DudeYarvie/JARViE_Bus_Extender/Reference Docs/Pics/Board_Annotated.jpg

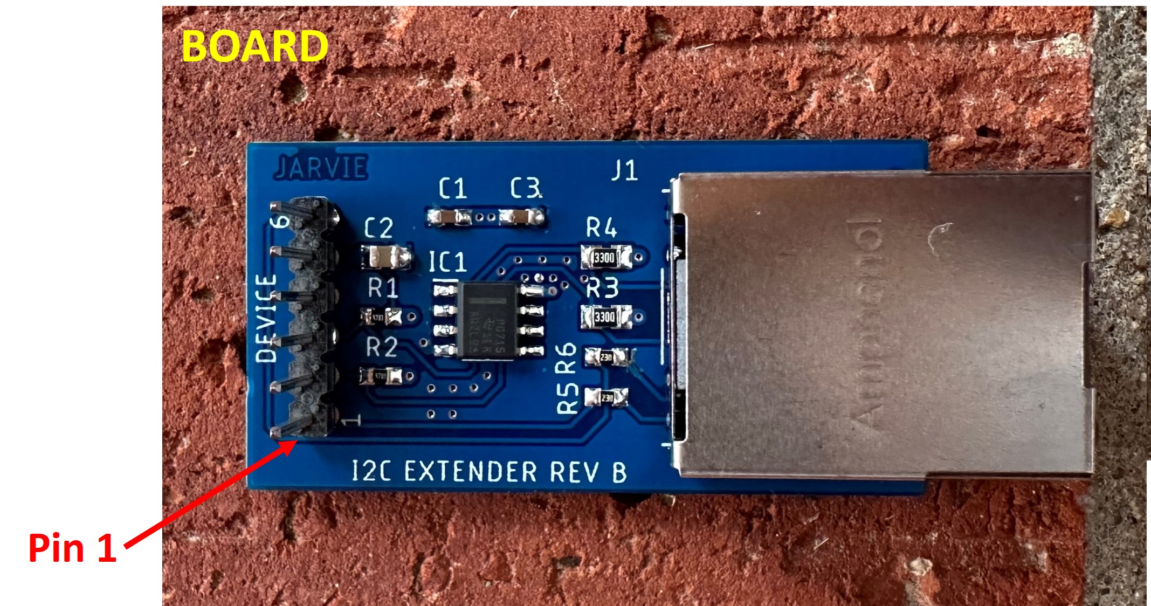
Reference Docs/Pics/Board_Annotated.jpg
