DudeYarvie/JARViE_Bus_Extender/Reference Docs/Pics/Buffer_Block_Diagram.jpg

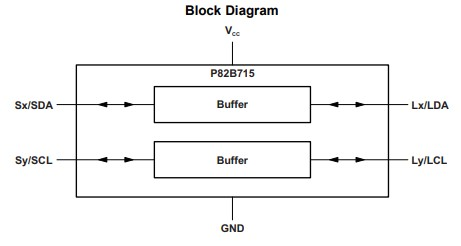
Reference Docs/Pics/Buffer_Block_Diagram.jpg
