DudeYarvie/JARViE_Bus_Extender/Reference Docs/Pics/Waveform_Measurements_Annotated.jpg

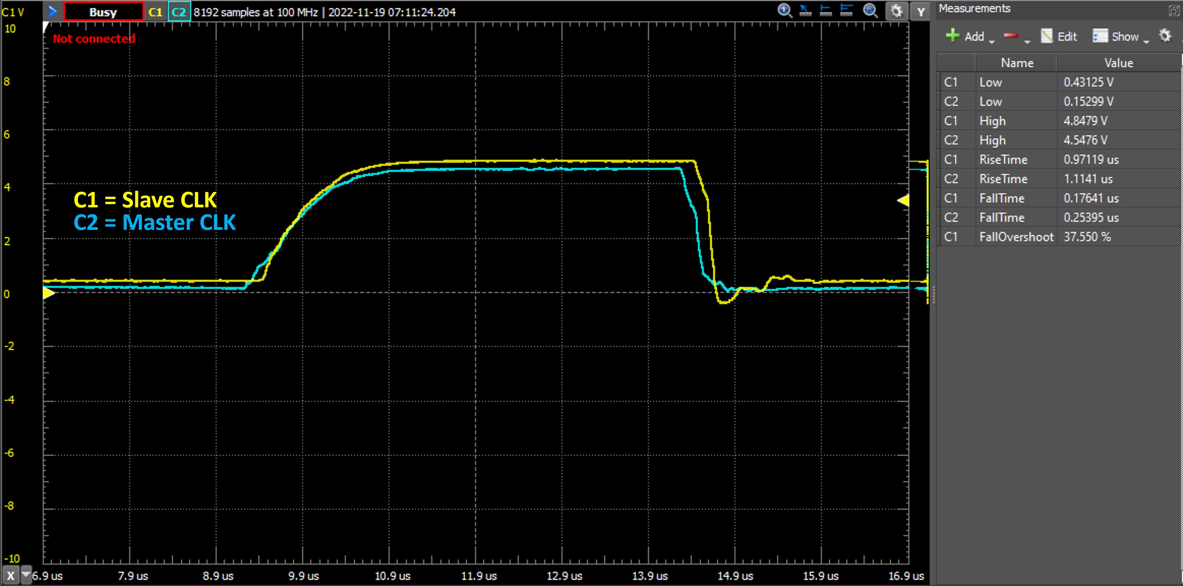
Reference Docs/Pics/Waveform_Measurements_Annotated.jpg
