DudeYarvie/JARViE_Bus_Extender/Reference Docs/I2C_SPI_extender/SCH, I2C_SPI_EXTENDER.pdf

A

A

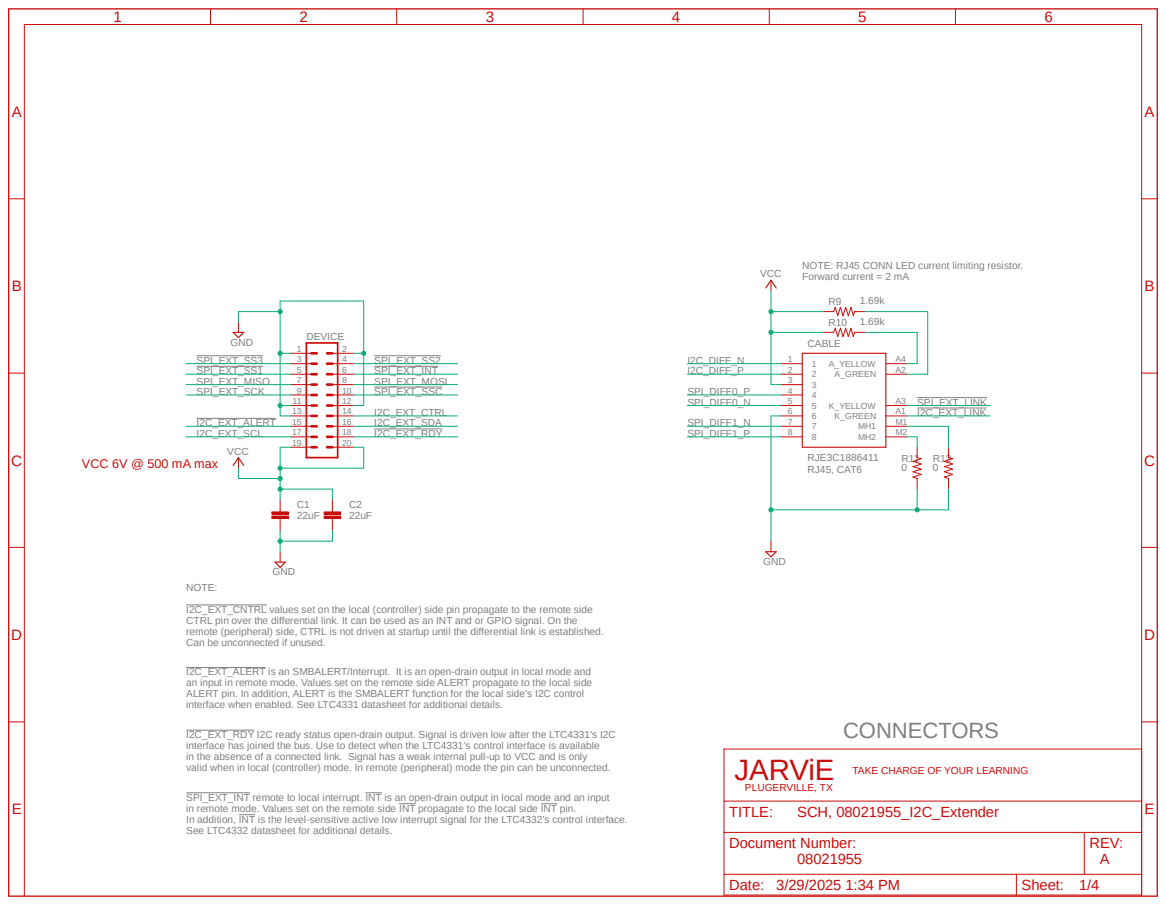
[picture p18: page 1]
RJ45, CAT6; CONNECTORS; NOTE:; GND; VCC; RJE3C1886411; K_YELLOW; A3 A_YELLOW; A4 K_GREEN; A1 A_GREEN; M2 CABLE 1; 20 DEVICE; SPI_EXT_LINK I2C_EXT_LINK; SPI_DIFF1_N SPI_DIFF1_P; SPI_DIFF0_P SPI_DIFF0_N; I2C_DIFF_N I2C_DIFF_P; I2C_EXT_SCL; I2C_EXT_RDY; I2C_EXT_ALERT; I2C_EXT_SDA; SPI_EXT_SSC; I2C_EXT_CTRL; SPI_EXT_SCK; SPI_EXT_MISO; SPI_EXT_MOSI; SPI_EXT_SS1; SPI_EXT_INT; SPI_EXT_SS3; SPI_EXT_SS2; JARViE; PLUGERVILLE, TX TITLE:; SCH, 08021955_I2C_Extender

NOTE: RJ45 CONN LED current limiting resistor.
Forward current = 2 mA

VCC 6V @ 500 mA max

I2C_EXT_CNTRL values set on the local (controller) side pin propagate to the remote side
CTRL pin over the differential link. It can be used as an INT and or GPIO signal. On the
remote (peripheral) side, CTRL is not driven at startup until the differential link is established.
Can be unconnected if unused.

I2C_EXT_ALERT is an SMBALERT/Interrupt. It is an open-drain output in local mode and
an input in remote mode. Values set on the remote side ALERT propagate to the local side
ALERT pin. In addition, ALERT is the SMBALERT function for the local side’s I2C control
interface when enabled. See LTC4331 datasheet for additional details.

I2C_EXT_RDY I2C ready status open-drain output. Signal is driven low after the LTC4331's I2C
interface has joined the bus. Use to detect when the LTC4331’s control interface is available
in the absence of a connected link. Signal has a weak internal pull-up to VCC and is only
valid when in local (controller) mode. In remote (peripheral) mode the pin can be unconnected.

TAKE CHARGE OF YOUR LEARNING

SPI_EXT_INT remote to local interrupt. INT is an open-drain output in local mode and an input
in remote mode. Values set on the remote side INT propagate to the local side INT pin.
In addition, INT is the level-sensitive active low interrupt signal for the LTC4332’s control interface.
See LTC4332 datasheet for additional details.

Document Number: 08021955 A | REV:

Date: 3/29/2025 1:34 PM | Sheet: 1/4

A

A

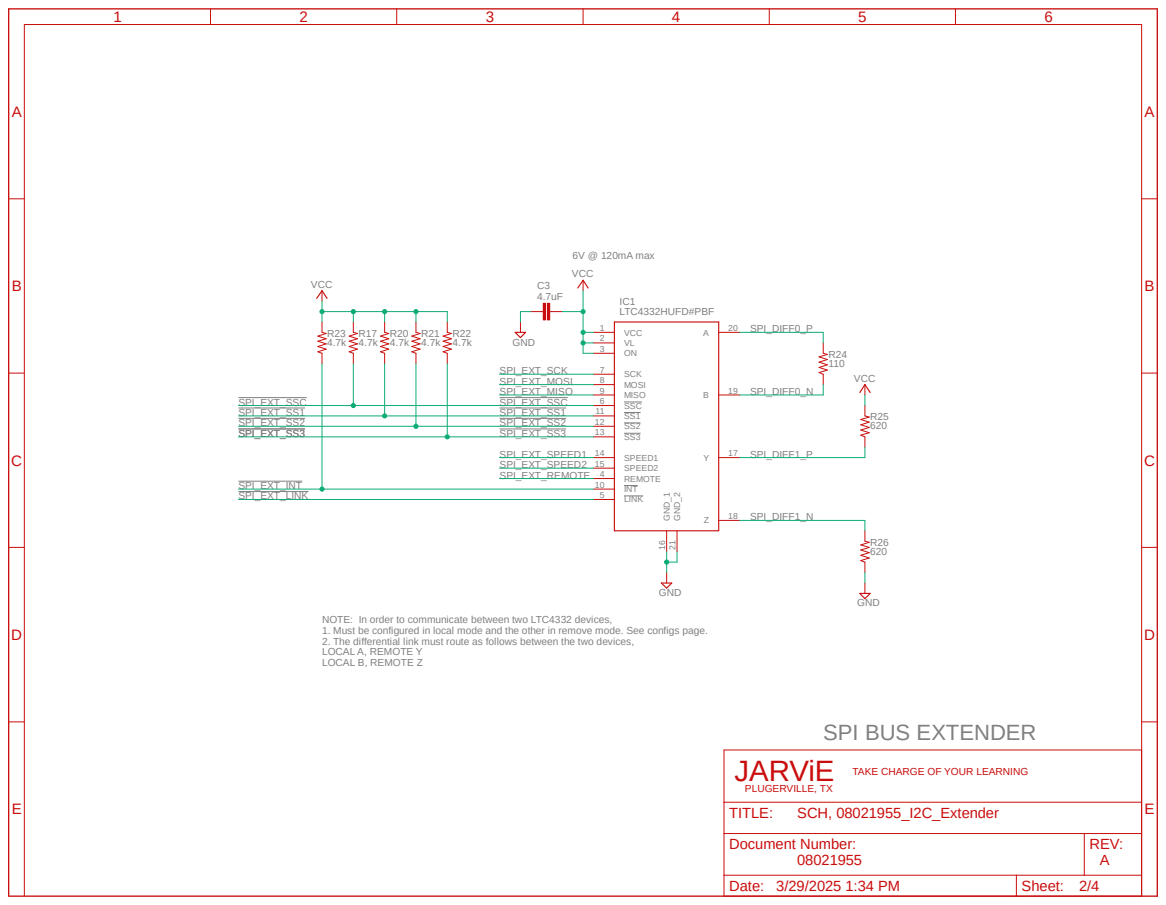
[picture p19: page 2]

NOTE: In order to communicate between two LTC4332 devices,
1. Must be configured in local mode and the other in remove mode. See configs page.
2. The differential link must route as follows between the two devices,
LOCAL A, REMOTE Y
LOCAL B, REMOTE Z

TAKE CHARGE OF YOUR LEARNING

Document Number: 08021955 A | REV:

A

A

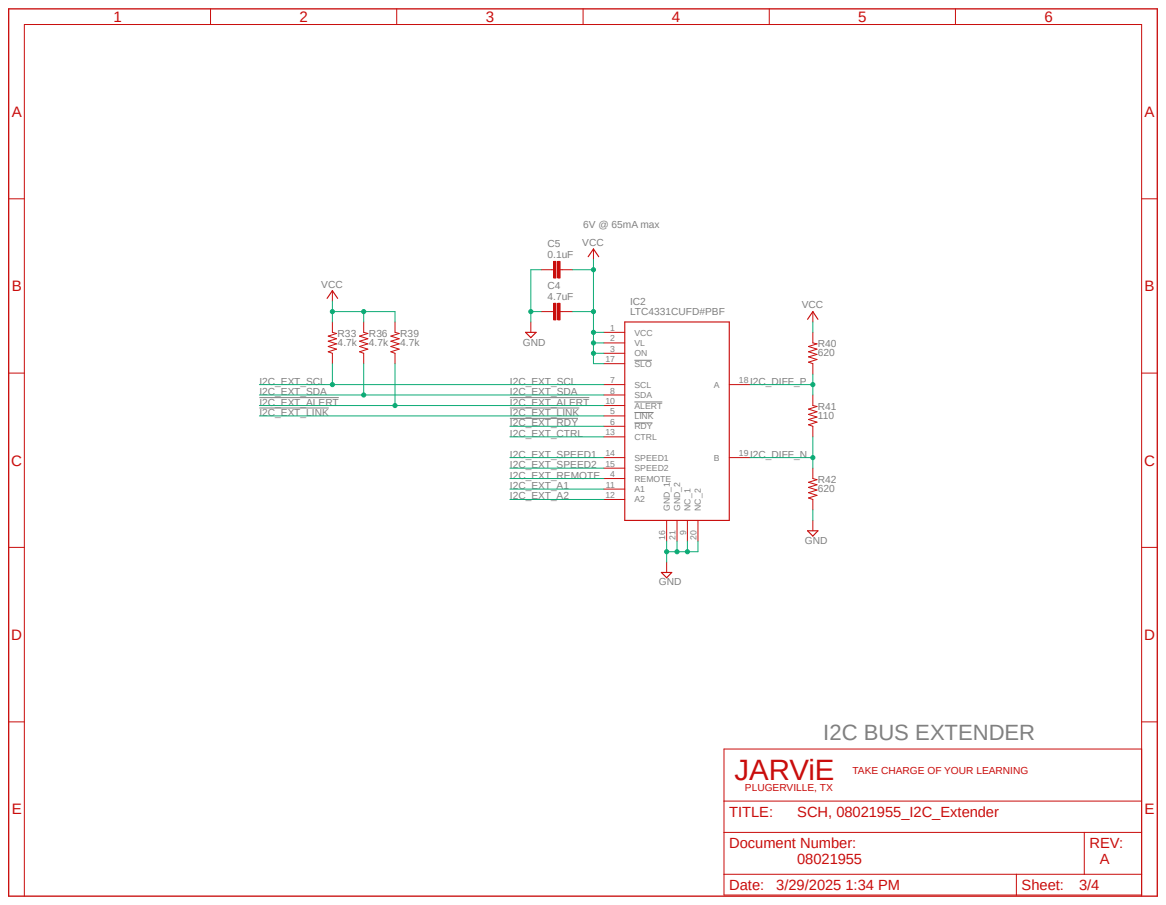
[picture p20: page 3]

TAKE CHARGE OF YOUR LEARNING

Document Number: 08021955 A | REV:

A

A

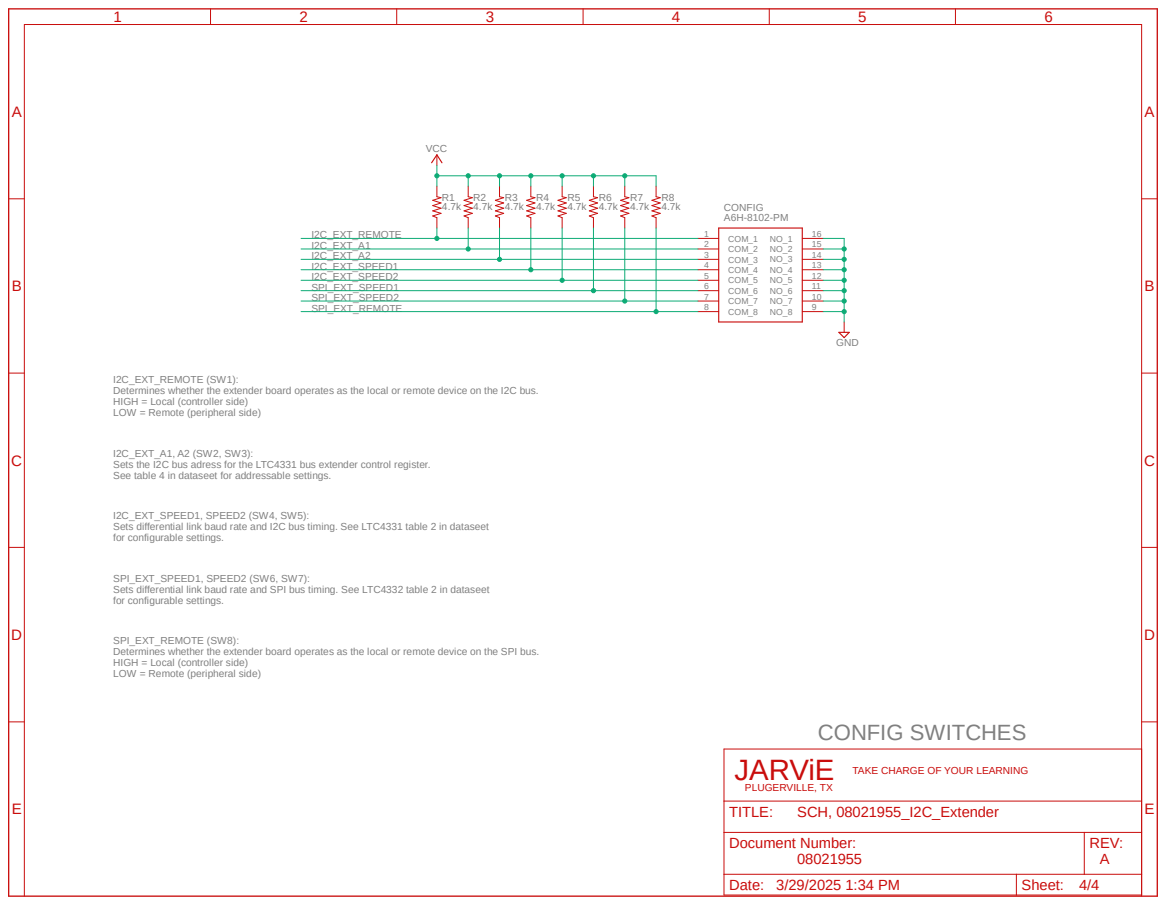
[picture p21: page 4]

I2C_EXT_REMOTE (SW1):
Determines whether the extender board operates as the local or remote device on the I2C bus.
HIGH = Local (controller side)
LOW = Remote (peripheral side)

I2C_EXT_A1, A2 (SW2, SW3):
Sets the I2C bus adress for the LTC4331 bus extender control register.
See table 4 in dataseet for addressable settings.

I2C_EXT_SPEED1, SPEED2 (SW4, SW5):
Sets differential link baud rate and I2C bus timing. See LTC4331 table 2 in dataseet
for configurable settings.

SPI_EXT_SPEED1, SPEED2 (SW6, SW7):
Sets differential link baud rate and SPI bus timing. See LTC4332 table 2 in dataseet

SPI_EXT_REMOTE (SW8):
Determines whether the extender board operates as the local or remote device on the SPI bus.

TAKE CHARGE OF YOUR LEARNING

Document Number: 08021955 | REV: A
