DudeYarvie/JARViE_Bus_Extender/Reference Docs/I2C_GPIO_extender/SCH, 08021955_I2C_GPIO_Extender.pdf

A

A

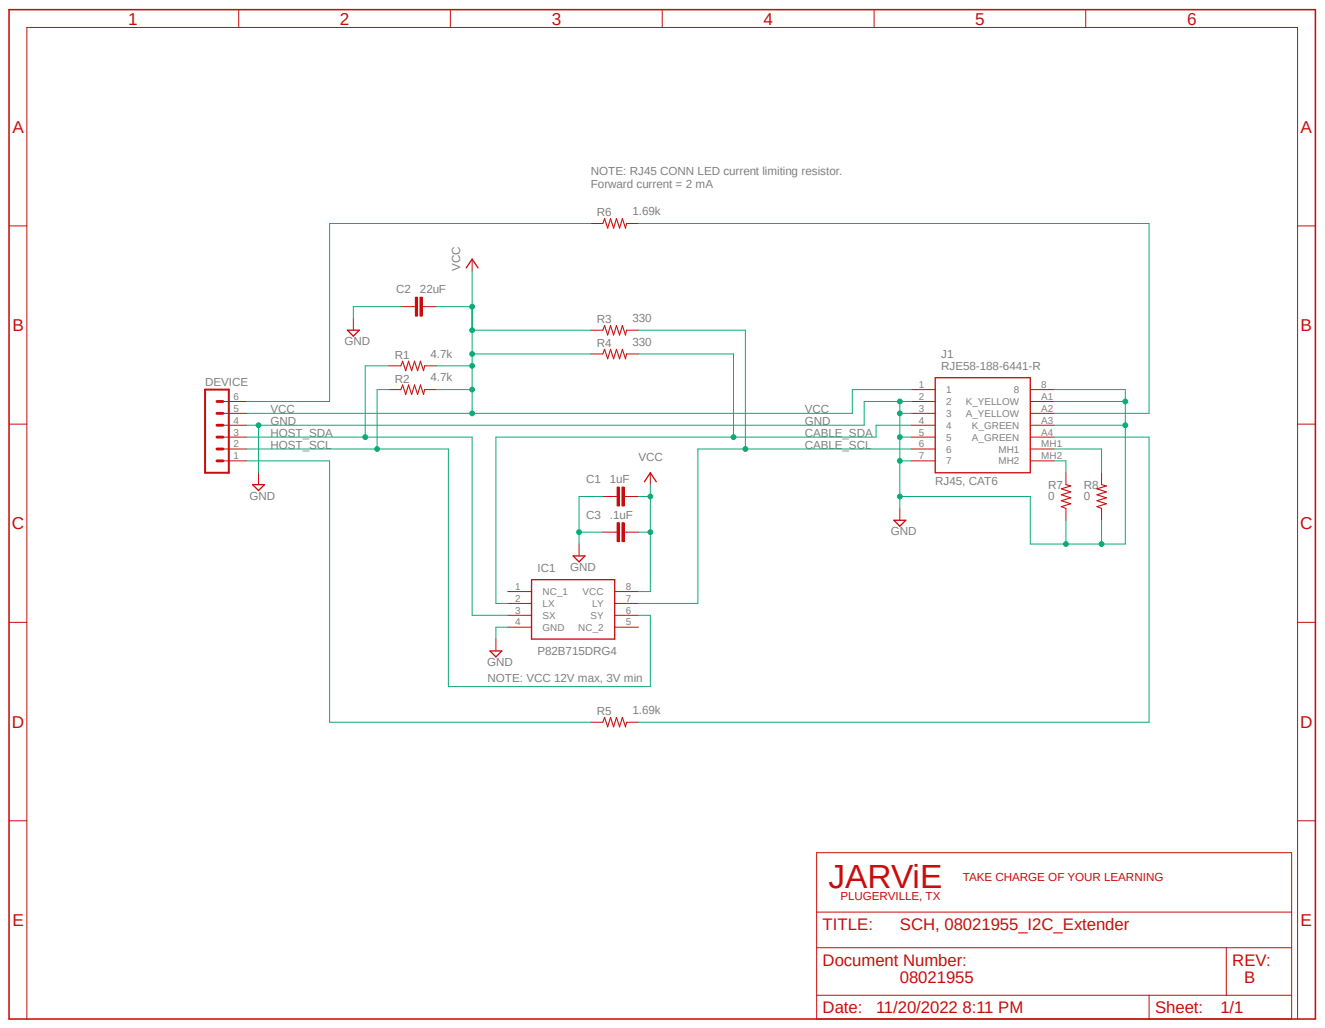
[picture p22: page 1]

NOTE: RJ45 CONN LED current limiting resistor.
Forward current = 2 mA

CABLE_SCL | | 6 6

GND
NOTE: VCC 12V max, 3V min

TAKE CHARGE OF YOUR LEARNING

Document Number: 08021955 | REV: B

Date: 11/20/2022 8:11 PM | Sheet: 1/1
