DudeYarvie/JARViE_Bus_Extender/(commit log)

2022-10-22 Uploading Rev A SCH and BOM
2022-11-21 Create Board_Annotated.png
    Board_Pin_1
2022-11-26 Adding cable pulse response pics
2022-12-12 Update BOM, 08021955_I2C_Extender.pdf
2025-06-01 Adding new bus extender
    Adding documents for JARViE I2C and SPI bus extender
